TheComet/WalkMod/Hardware/Images/analog_stick.png

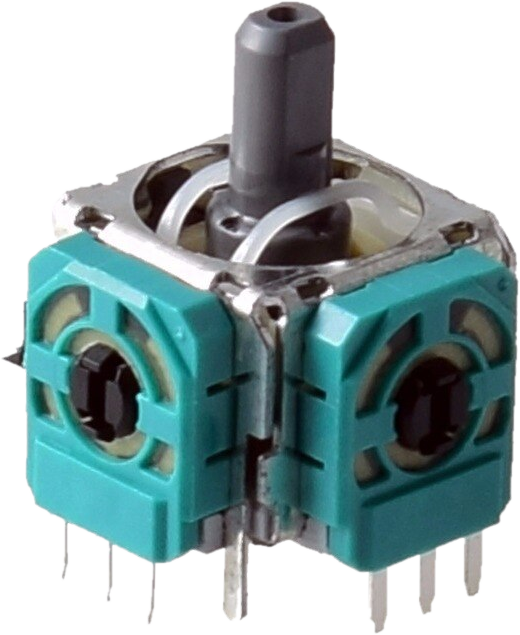
Hardware/Images/analog_stick.png
