TheComet/WalkMod/Hardware/Images/ground.png

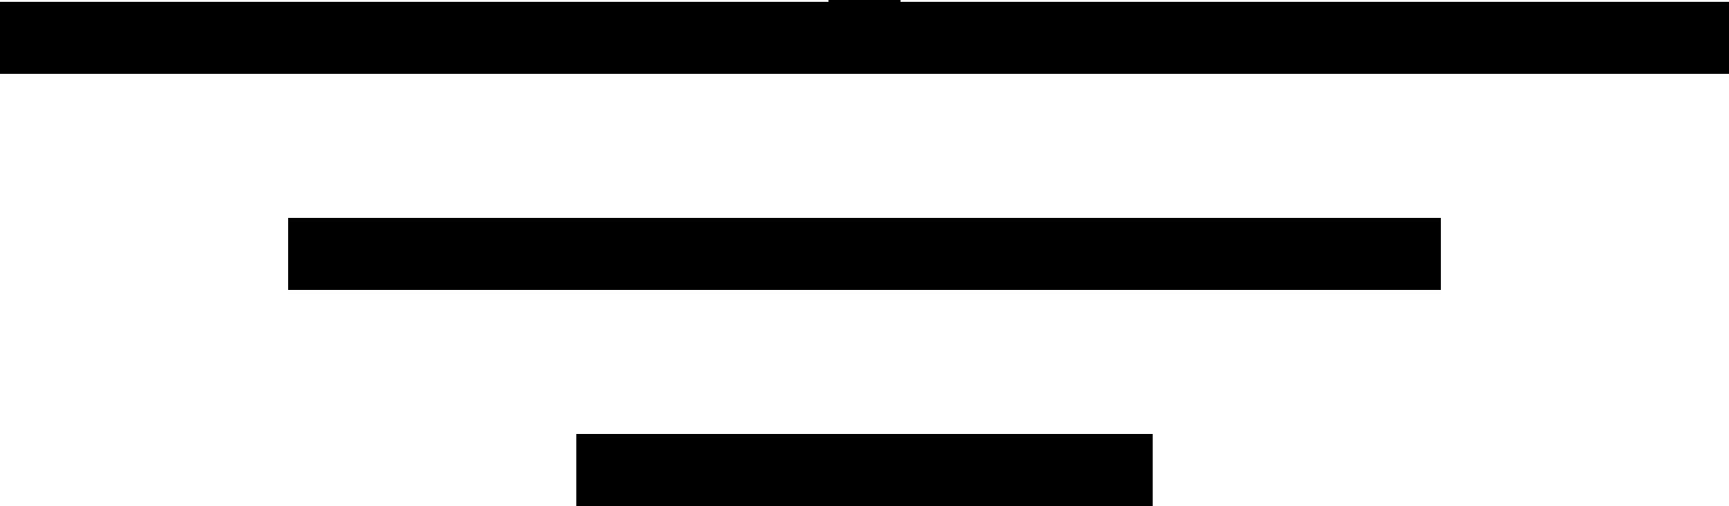
Hardware/Images/ground.png
