TheComet/WalkMod/Hardware/Fabrication/AngleMod V1/BOM/Bill of Materials-AngleMod V1.xlsx

Quantity | Designator | Name | Type | Value | Value2 | Footprint | Manufacturer 1 | Manufacturer Part Number 1 | Supplier 1 | Supplier Part Number 1 | Note
2 | C1, C2 | CC0603KRX7R6BB224 | CC0603KRX7R6BB224 | 220nF | 10V | CX7R0603K
1 | C3 | 06036C105JAT2A |  | 1uF | 6.3V | CX7R0603K
3 | C4, C5, C6 | 04025C104JAT2A |  | 100nF | 50V | CX7R0402C
1 | C7 | 04025C104JAT2A |  | 10nF | 50V | CX7R0402C
7 | P1, P2, P3, P4, P5, P6, P7 | SMD Pad 1 pin |  |  |  | PAD_2X1.5_SQUARE
2 | P8, P9 | TSW-106-23-F-S | TSW-106-23-F-S |  |  | TSW-106-23-F-S_SIDEA | Samtec Inc. | TSW-106-23-F-S
2 | R1, R2 | RG1005P-472-B-T5 | RG1005P-472-B-T5 | 4.7k | 62.5mW | RT0402_C
2 | R3, R4 | TBD | TBD | 10k | 62.5mW | RT0402_C
1 | R5 | TBD | TBD | 470E | 62.5mW | RT0402_C
1 | U1 | TSV632IQ2T | TSV632IQ2T |  |  | DFN-8_2X2_0.5_C | STMicroelectronics | TSV632IQ2T
1 | U2 | NX3L4053HR,115 | NX3L4053HR,115 |  |  | HXQFN-16_SOT-1039-2_C | NX3L4053HR,115 | NXP USA Inc.
1 | U3 | MCP48FVB12-E/UN | MCP48FVB12-E/UN |  |  | MSOP-10_0.5_C | Microchip Technology | MCP48FVB12-E/UN
1 | U4 | PIC16F15245T-I/REB | PIC16F15245T-I/REB |  |  | VQFN-20_0.4_C | Microchip Technology | PIC16F15245T-I/REB
