TheComet/WalkMod/Hardware/Fabrication/Rev C0/BOM/Bill of Materials-WalkMod C0.xlsx

Quantity | Designator | Name | Type | Value | Value2 | Footprint | Manufacturer 1 | Manufacturer Part Number 1 | Supplier 1 | Supplier Part Number 1 | Note
2 | C1, C4 | CL10B105KA8NFNC | CL10B105KA8NFNC | 1uF | 25V | CX7R0603K
1 | C2 | CL10B474KO8NFNC | CL10B474KO8NFNC | 470nF | 16V | CX7R0603K
1 | C3 | CC0603KRX7R6BB224 | CC0603KRX7R6BB224 | 220nF | 10V | CX7R0603K
7 | P1, P2, P3, P4, P5, P6, P8 | SMD Pad 1 pin |  |  |  | PAD_2X1.5_SQUARE
1 | P7 | DS05-127-2-06BK-SMT-TR | DS05-127-2-06BK-SMT-TR |  |  | CUI-DS05-127-2-06BK-SMT_C
1 | Q1 | BC857B-TP | BC857B-TP |  |  | BC8xx_SOT23-3_C
13 | R1, R2, R3, R4, R5, R6, R7, R8, R9, R10, R11, R12, R13 | RG1005P-472-B-T5 | RG1005P-472-B-T5 | 4.7k | 62.5mW | RT0402_C
3 | RA, RB, RC | 3214W-1-103E | 3214W-1-103E | 10k | 250mW | BOURNS_3214W_C | Bourns | 3214W-1-103E | Digi-Key | 3214W-103ETR-ND
1 | U1 | NX3L4053HR,115 | NX3L4053HR,115 |  |  | HXQFN16_SOT1039-2_C | NX3L4053HR,115 | NXP USA Inc.
1 | U2 | LTC2068HUD#PBF | LTC2068HUD#PBF |  |  | QFN16_0.5_C | Analog Devices Inc. | LTC2068HUD#PBF
