TheComet/WalkMod/Hardware/Fabrication/Rev A0/Broad/BOM/Bill of Materials-WalkMod(Broad).xlsx

Quantity | Designator | Name | Type | Value | Value2 | Footprint | Manufacturer 1 | Manufacturer Part Number 1 | Supplier 1 | Supplier Part Number 1 | Note
0 | P1, P2, P3, P4, P5, P6, P7 | SMD Pad 1 pin |  |  |  | PAD_2X1.5_SQUARE, PAD_1.8X0.95_SQUARE
2 | Q1, Q2 | BC857B-TP | BC857B-TP |  |  | BC8xx_SOT23-3_C | MCC | BC857B-TP | Digi-Key | BC857B-TPMSTR-ND
1 | Q3 | BC847B-TP | BC847B-TP |  |  | BC8xx_SOT23-3_C | MCC | BC847B-TP | Digi-Key | BC847B-TPTR-ND
3 | R1, R2, R8 | RT0402DRD0747KL | RT0402DRD0747KL | 47k | 62.5mW | RT0402_C | Yageo | RT0402DRD0747KL | Digi-Key | 311-2187-2-ND
2 | R3, R6 | AT0402FRE0710KL | AT0402FRE0710KL | 10k | 62.5mW | AT0402_C | Yageo | AT0402FRE0710KL | Digi-Key | YAG2104CT-ND
1 | R4 | 3214W-1-103E | 3214W-1-103E | 10k | 250mW | BOURNS_3214W_C | Bourns | 3214W-1-103E | Digi-Key | 3214W-103ETR-ND
1 | R5 | #NAME? | RC0402FR-070RL | 0E | 62.5mW | RC0402_C | Yageo | RC0402FR-070RL | Digi-Key | 311-0.0LRTR-ND
0 | R7 | AT0402FRE0710KL | AT0402FRE0710KL | 10k | 62.5mW | AT0402_C | Yageo | AT0402FRE0710KL | Digi-Key | YAG2104CT-ND
