TheComet/WalkMod/Hardware/Fabrication/AngleMod V1/Doc/AngleMod.PDF

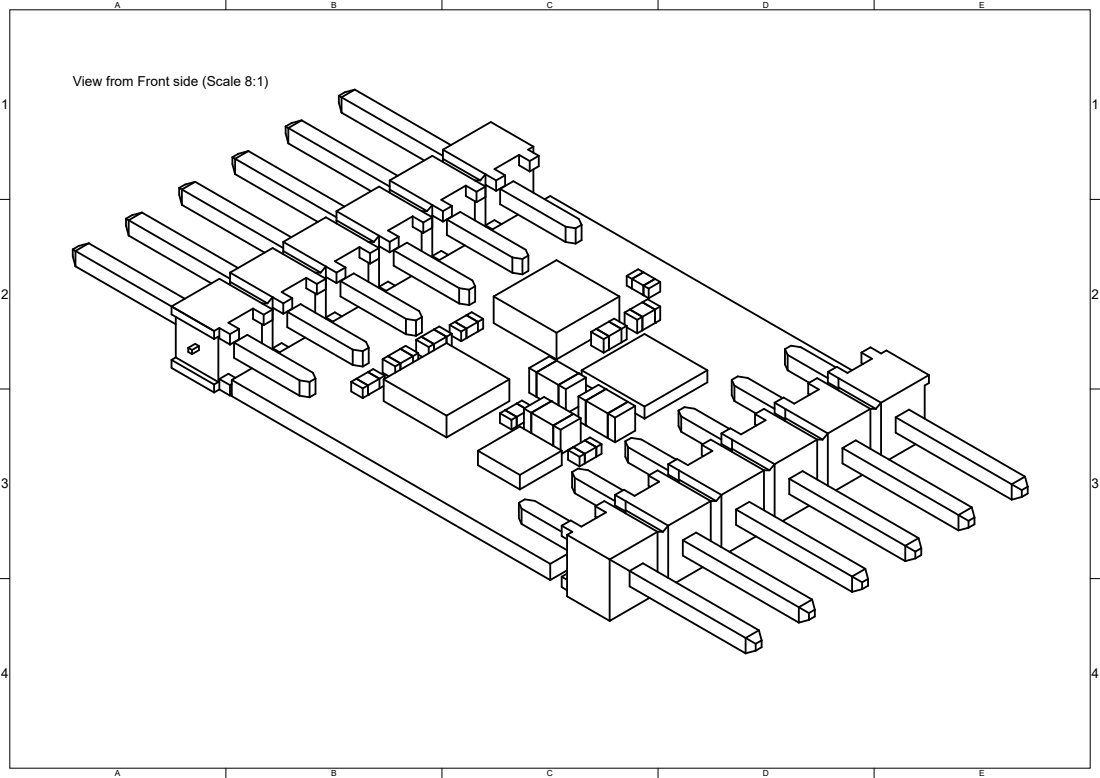
[picture p3: page 1]

View from Front side (Scale 8:1)

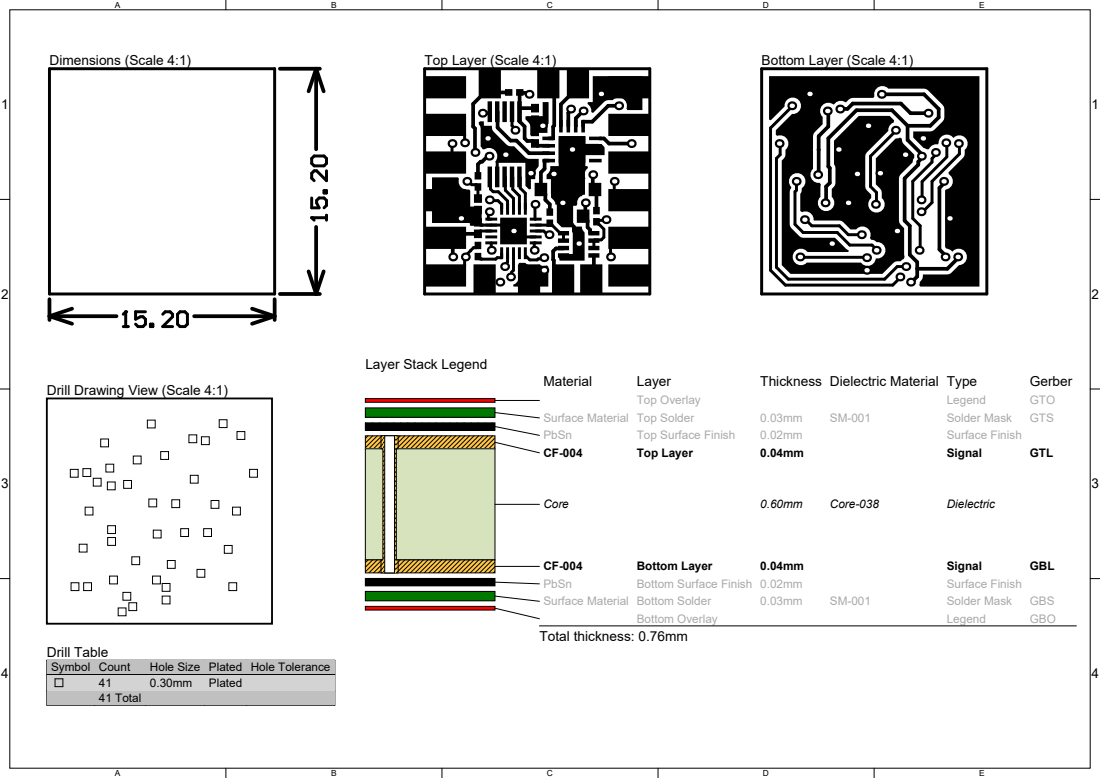
[picture p4: page 2]

Drill Drawing View (Scale 4:1)

Symbol | Count | Hole Size | Plated | Hole Tolerance

41 | 0.30mm | Plated
41 Total

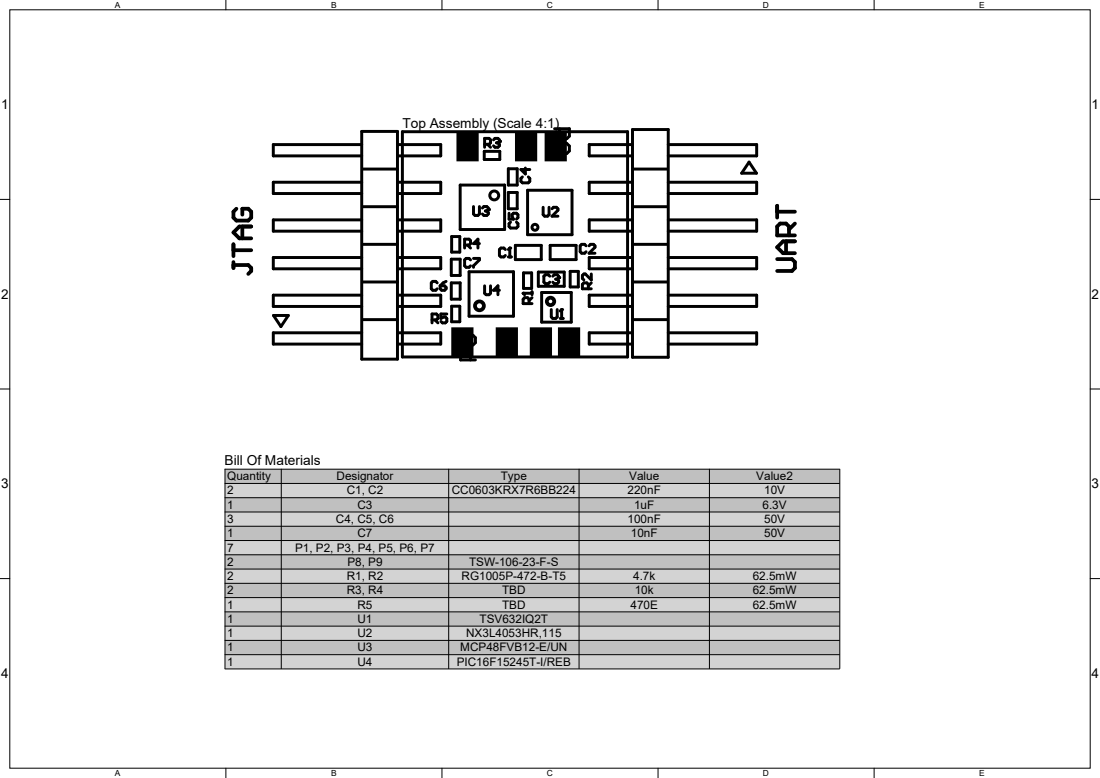
[picture p5: page 3]

Quantity | Designator | Type | Value | Value2
2 | C1, C2 | CC0603KRX7R6BB224 | 220nF | 10V
1 | C3 | | 1uF | 6.3V
3 | C4, C5, C6 | | 100nF | 50V
1 | C7 | | 10nF | 50V
7 | P1, P2, P3, P4, P5, P6, P7
2 | P8, P9 | TSW-106-23-F-S
2 | R1, R2 | RG1005P-472-B-T5 | 4.7k | 62.5mW
2 | R3, R4 | TBD | 10k | 62.5mW
1 | R5 | TBD | 470E | 62.5mW
1 | U1 | TSV632IQ2T
1 | U2 | NX3L4053HR,115
1 | U3 | MCP48FVB12-E/UN
1 | U4 | PIC16F15245T-I/REB

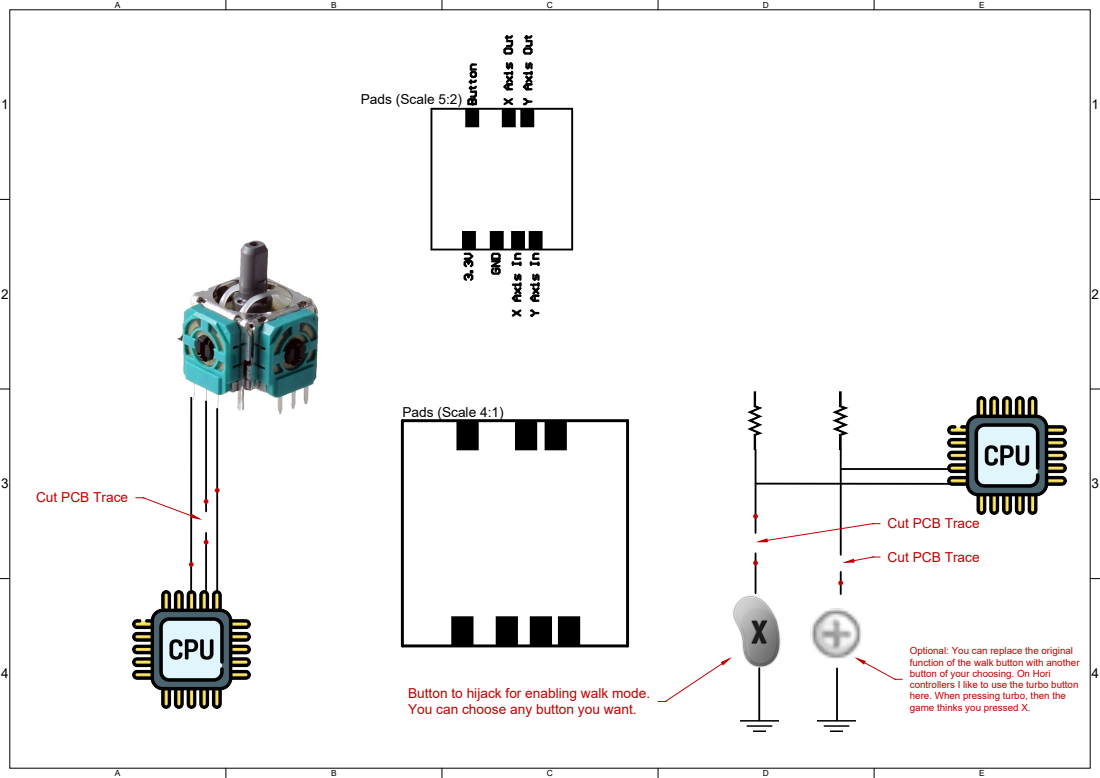
[picture p6: page 4]

Optional: You can replace the original
function of the walk button with another
button of your choosing. On Hori
controllers I like to use the turbo button
here. When pressing turbo, then the
game thinks you pressed X.

Button to hijack for enabling walk mode.
You can choose any button you want.

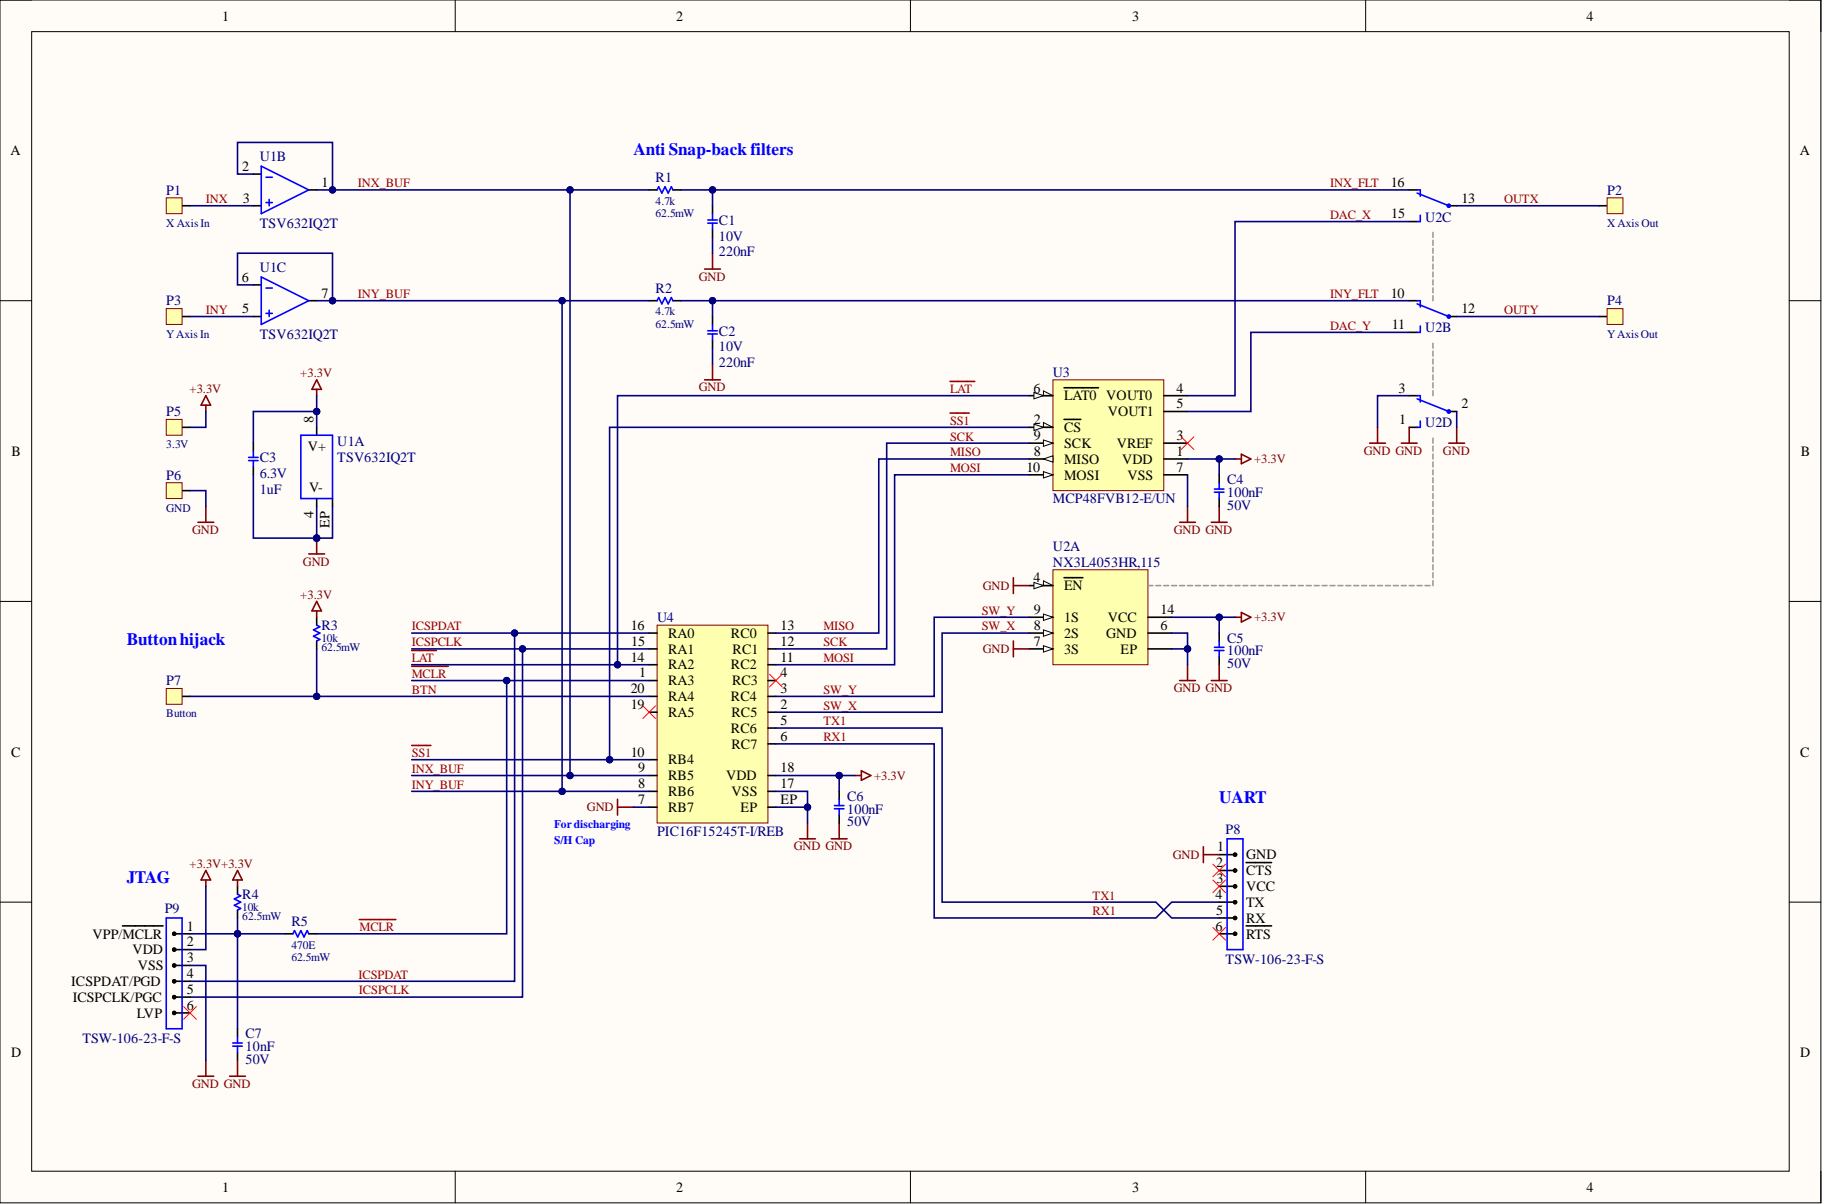
[picture p7: page 5]

8 | SCK 9

n +3.3V | S S 1 IN X_BU F IN Y_BU F MCL R | | S W_X
