TheComet/WalkMod/Hardware/Fabrication/Rev C0/Doc/WalkMod.PDF

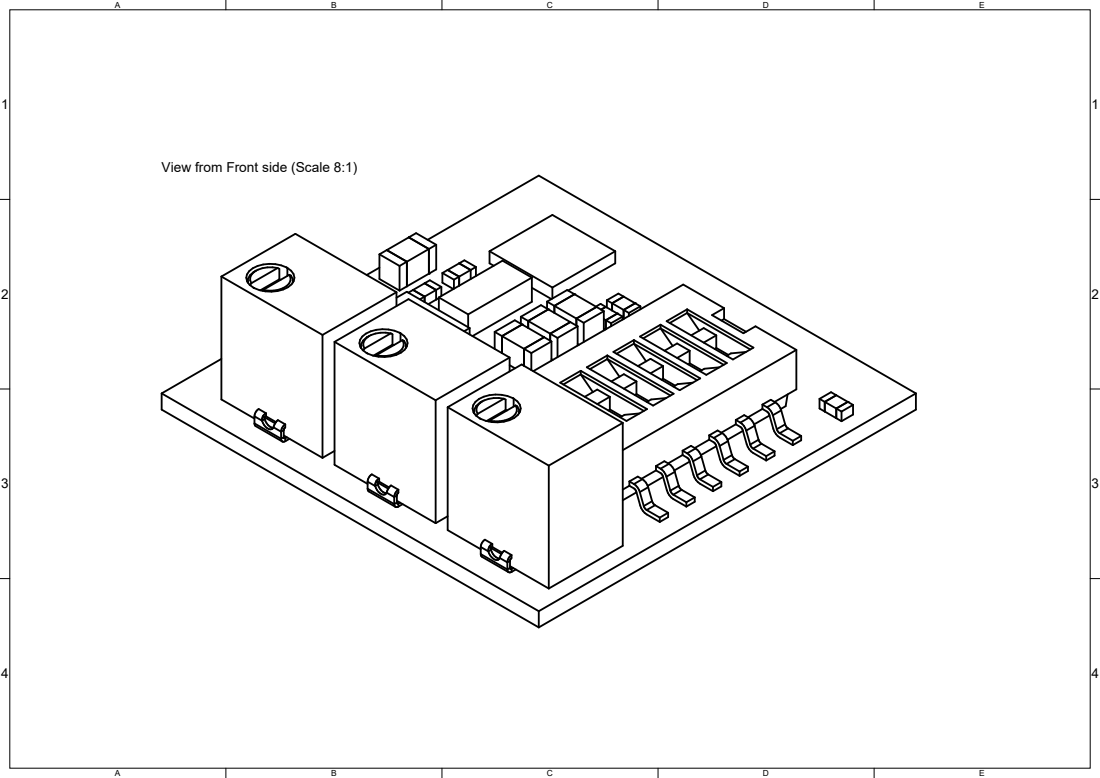
[picture p8: page 1]

View from Front side (Scale 8:1)

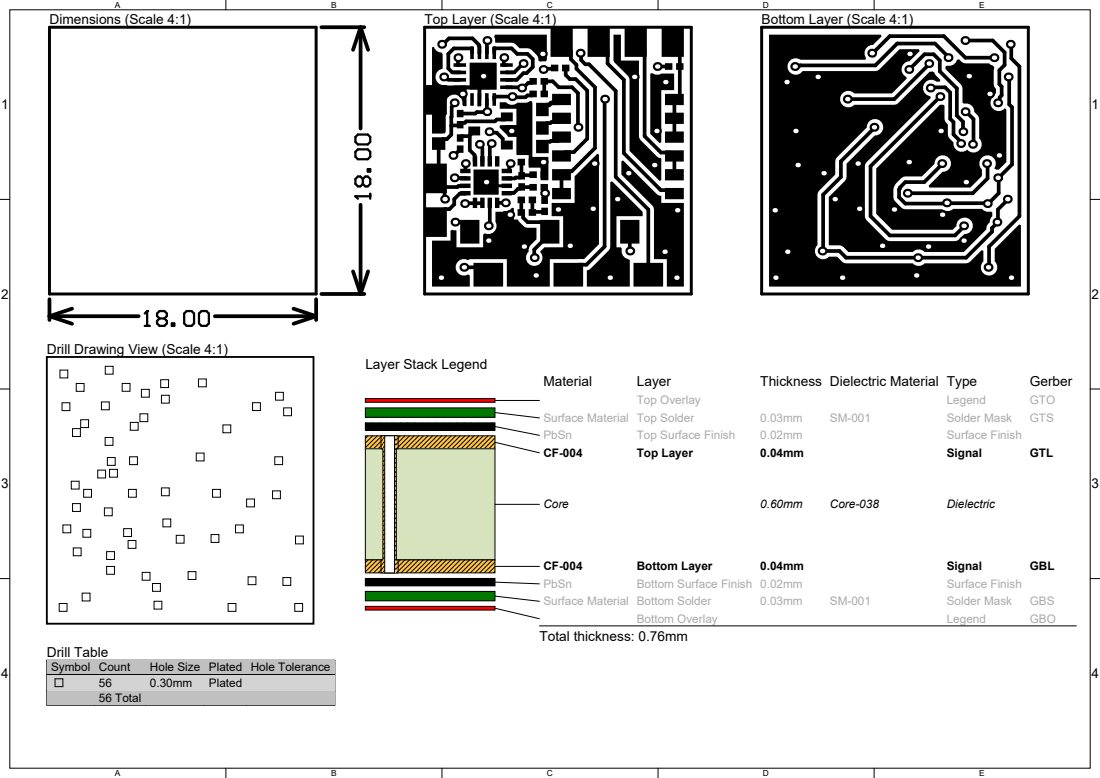
[picture p9: page 2]

Drill Drawing View (Scale 4:1)

Symbol | Count | Hole Size | Plated | Hole Tolerance

56 | 0.30mm | Plated
56 Total

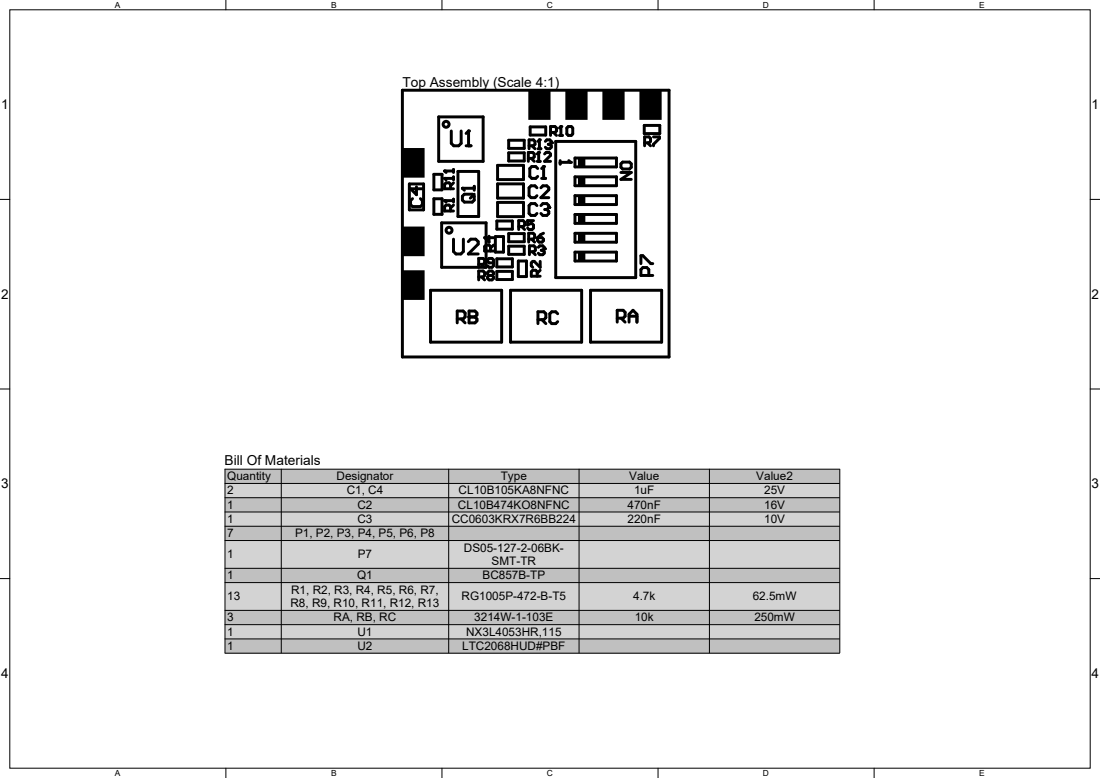
[picture p10: page 3]

Quantity | Designator | Type | Value | Value2
2 | C1, C4 | CL10B105KA8NFNC | 1uF | 25V
1 | C2 | CL10B474KO8NFNC | 470nF | 16V
1 | C3 | CC0603KRX7R6BB224 | 220nF | 10V
7 | P1, P2, P3, P4, P5, P6, P8
1 | P7 | DS05-127-2-06BK-SMT-TR

1 | Q1 | BC857B-TP
13 | R1, R2, R3, R4, R5, R6, R7, R8, R9, R10, R11, R12, R13 | RG1005P-472-B-T5 | 4.7k | 62.5mW

3 | RA, RB, RC | 3214W-1-103E | 10k | 250mW
1 | U1 | NX3L4053HR,115
1 | U2 | LTC2068HUD#PBF

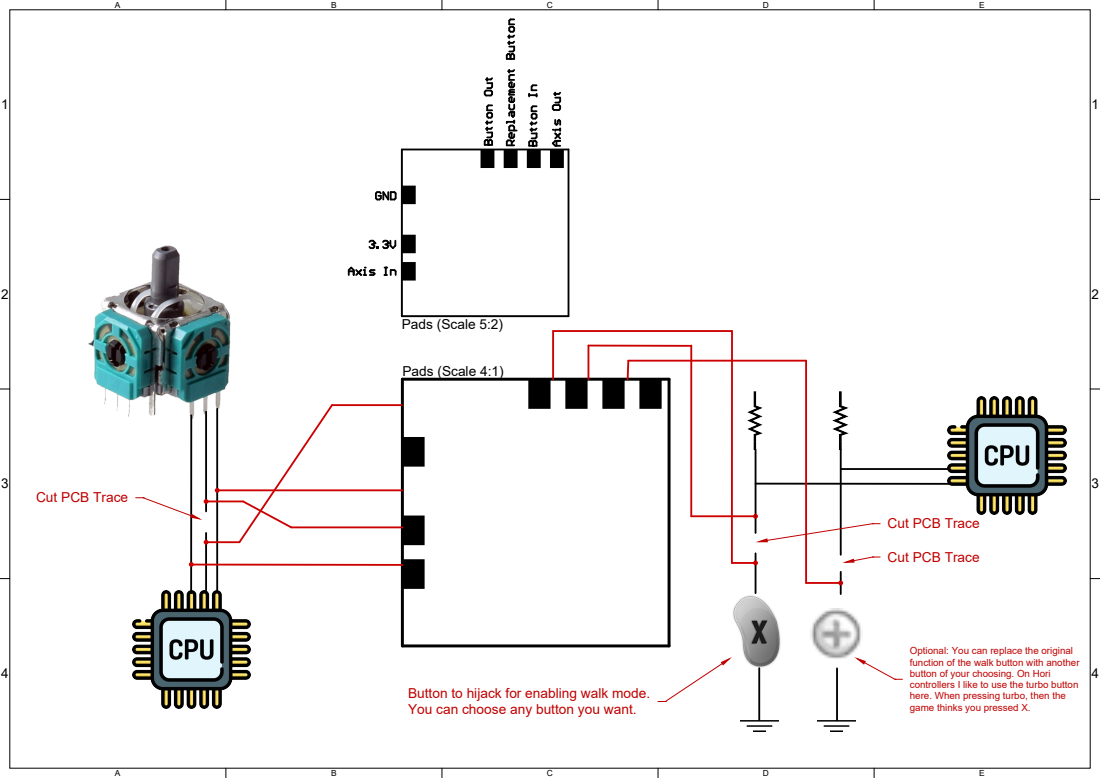
[picture p11: page 4]

Optional: You can replace the original
function of the walk button with another
button of your choosing. On Hori
controllers I like to use the turbo button
here. When pressing turbo, then the
game thinks you pressed X.

Button to hijack for enabling walk mode.
You can choose any button you want.

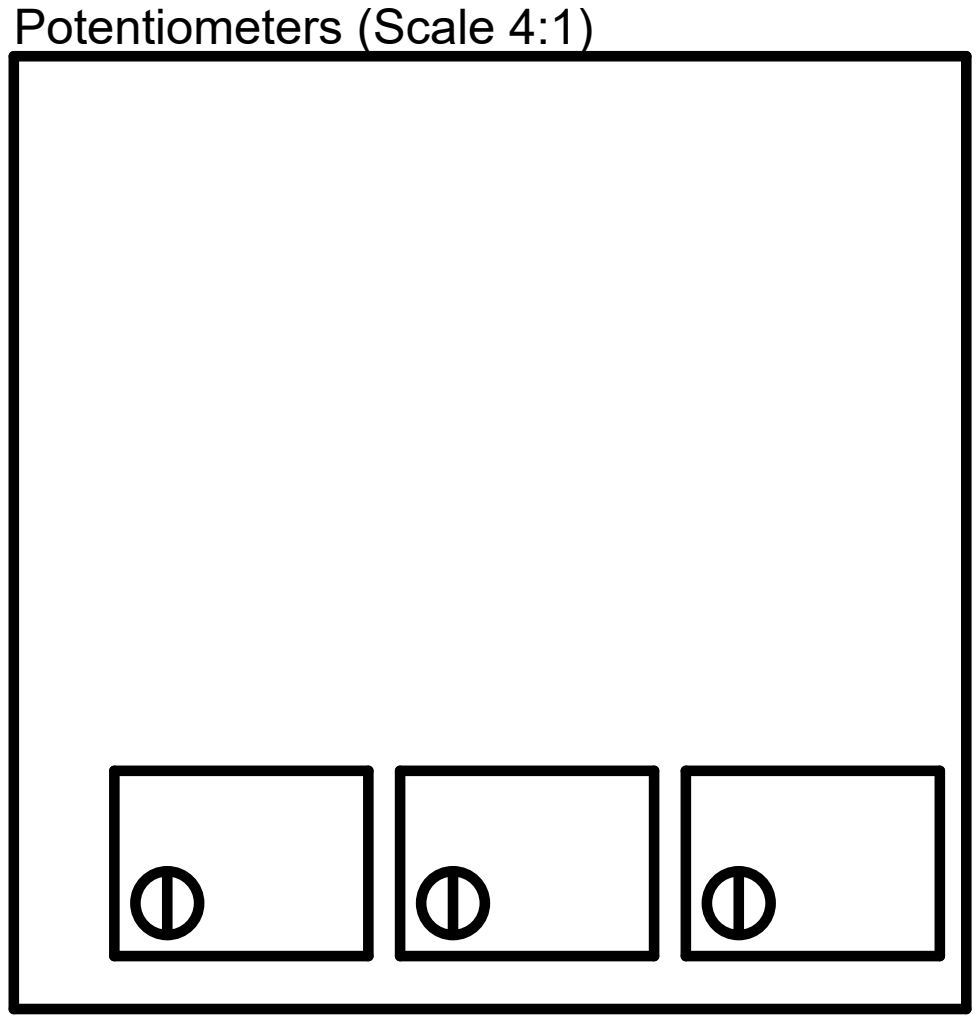
[picture p12: page 5]

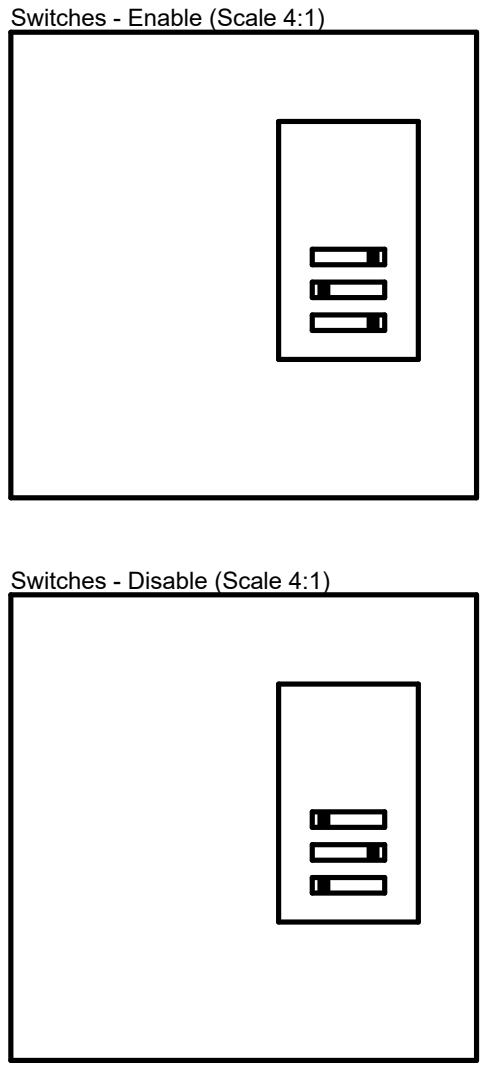
[picture p13: page 6]

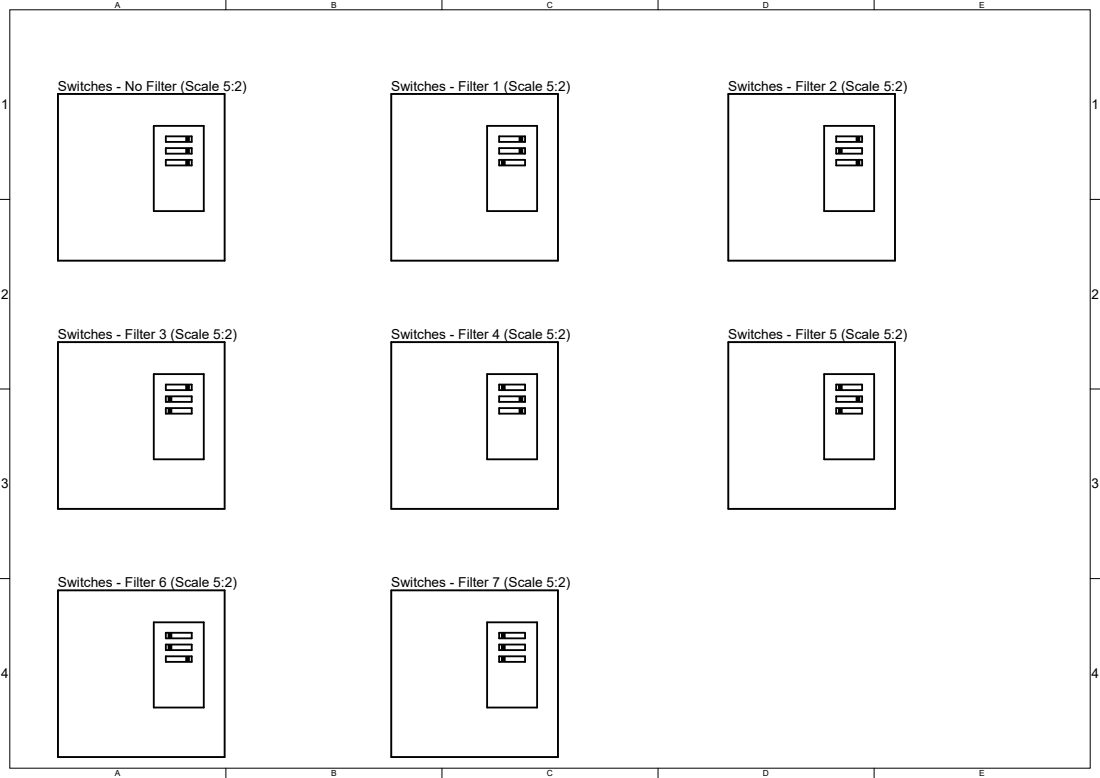
[picture p14: page 7]

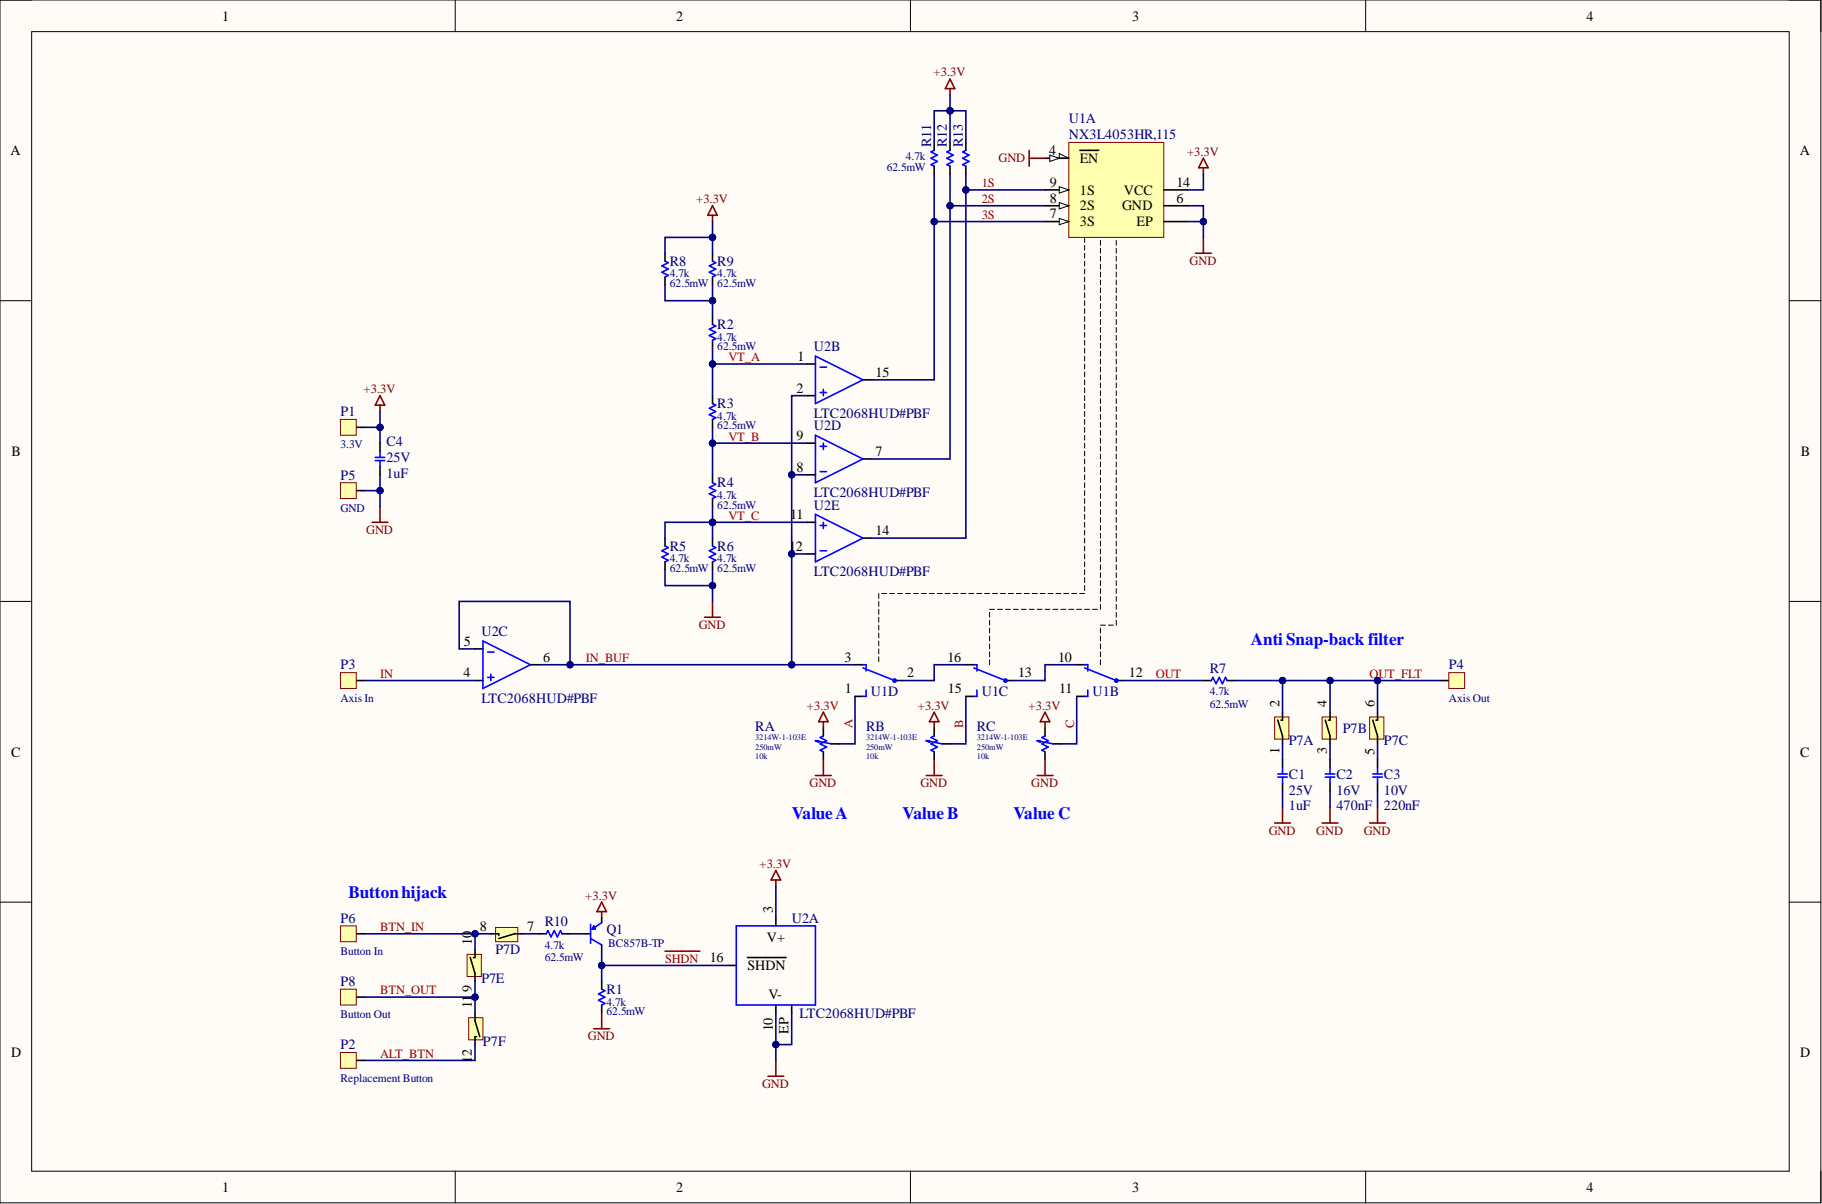
[picture p15: page 8]

Anti Snap-back filter
