TheComet/WalkMod/Hardware/Fabrication/Rev A0/Broad/Doc/WalkMod.PDF

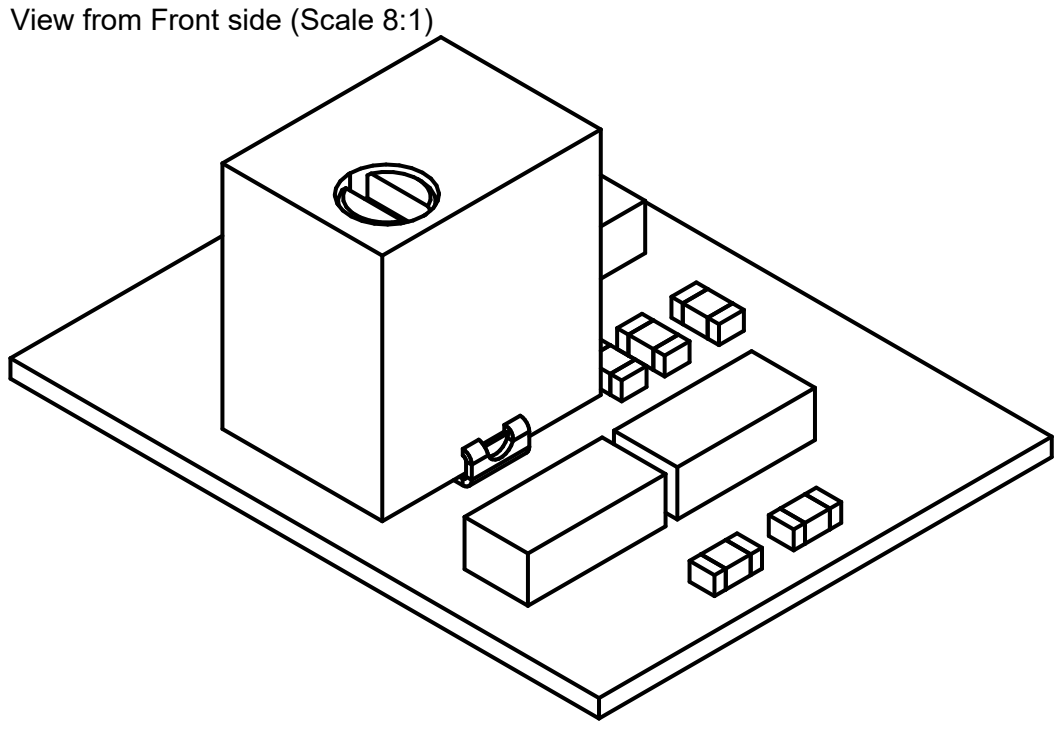
[picture p24: page 1]

View from Front side (Scale 8:1)

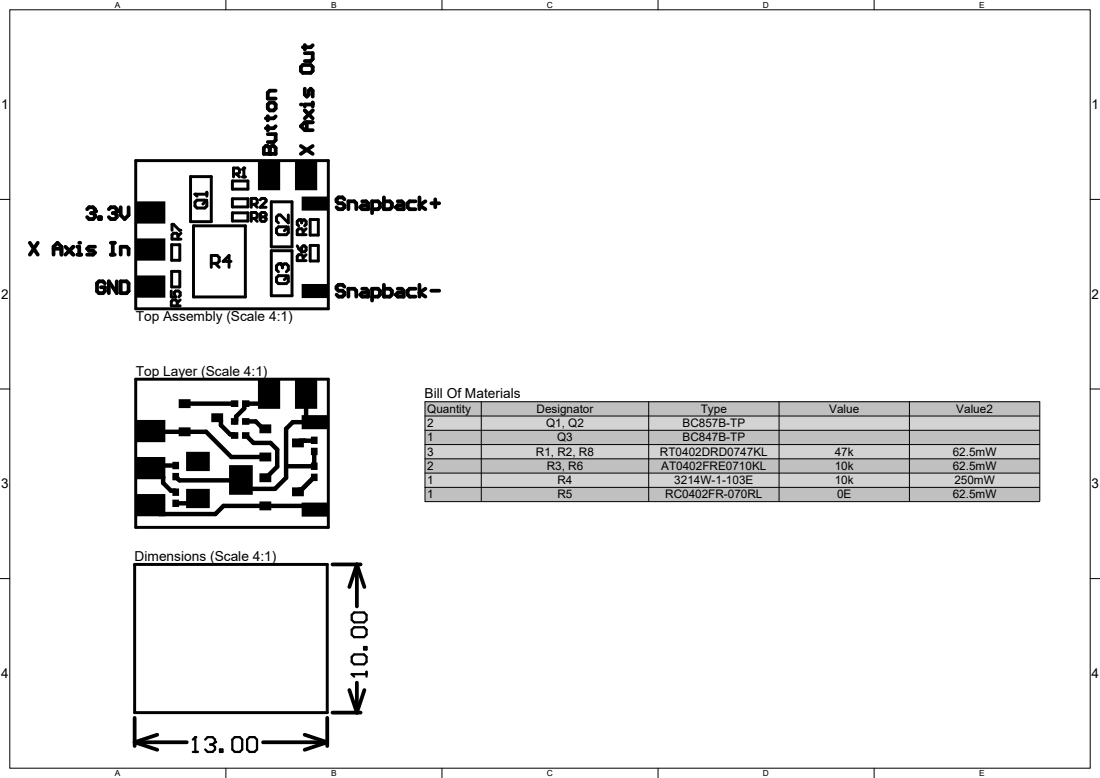
[picture p25: page 2]

Quantity | Designator | Type | Value | Value2
2 | Q1, Q2 | BC857B-TP
1 | Q3 | BC847B-TP
3 | R1, R2, R8 | RT0402DRD0747KL | 47k | 62.5mW
2 | R3, R6 | AT0402FRE0710KL | 10k | 62.5mW
1 | R4 | 3214W-1-103E | 10k | 250mW
1 | R5 | RC0402FR-070RL | 0E | 62.5mW

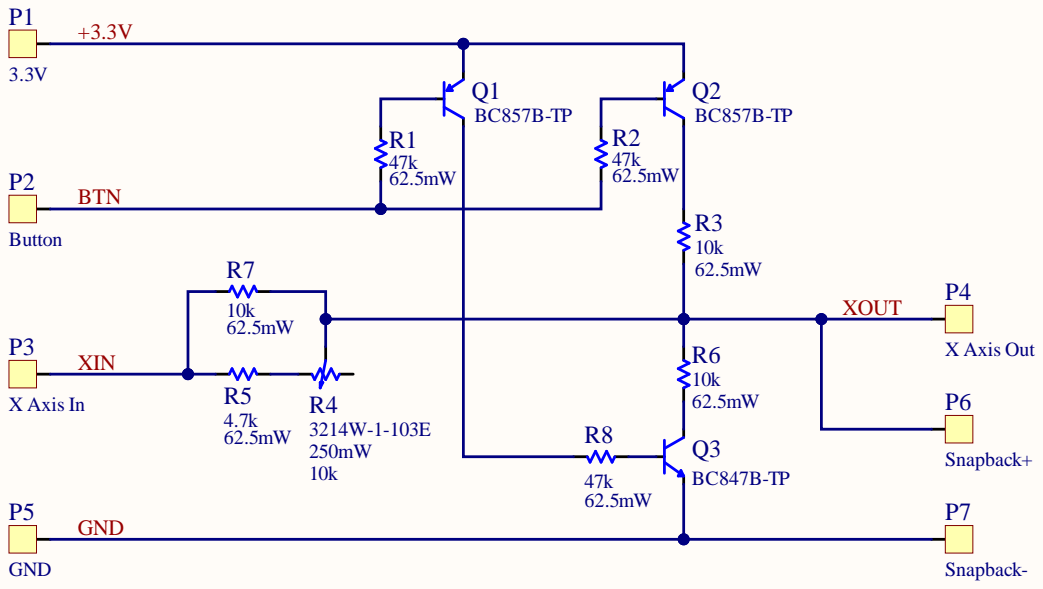
[picture p26: page 3]
