TheComet/WalkMod/Simulations/WalkMod2.asc

A1: xor
A2: xor
R1: res; {Rx-xpos*Rx}
R2: res; {xpos*Rx}
R3: res; 2.2k
R4: res; 10k
R5: res; 2.2k
R6: res; 10k
R7: res; 4.7k
R8: res; 10k
R12: res; {Rx-xpos*Rx}
R13: res; {xpos*Rx}
R14: res; 1483
R15: res; 517
S1: sw
U4: LT1810
V1: voltage; 3.3
V2: voltage; 2.15
V3: voltage; 1.15
V4: voltage; 2.4469
Named nets: 0, +3.3V, normal, target, tilt_l, tilt_h, dzip
.param Rx=10k
.step param xpos 0.01 0.99 0.01
.op
.param Rtrim=10k
