TheComet/WalkMod/Simulations/WalkMod.asc

Q1: pnp; BC807-16
Q2: npn; BC817-16
Q3: pnp; BC807-16
R1: res; {Rx-xpos*Rx}
R2: res; {xpos*Rx}
R3: res; 4.7k
R4: res; {Rtrim*trimpos}
R5: res; 10k
R6: res; 47k
R7: res; 47k
R8: res; 47k
R9: res; 10k
R10: res; 10k
R11: res; 2k
R12: res; {Rx-xpos*Rx}
R13: res; {xpos*Rx}
R14: res; 1483
R15: res; 517
V1: voltage; 3.3
Named nets: 0, +3.3V, modded, normal, target
.param Rx=10k
.step param xpos 0.01 0.99 0.01
.op
.param Rtrim=10k
.step param trimpos 0.1 0.9 0.1
