TheComet/WalkMod/(list of files, drawings)

Other design files:
Hardware/AngleMod V1/AngleMod V1.PcbDoc
Hardware/AngleMod V1/AngleMod V1.PrjPcb
Hardware/AngleMod V1/AngleMod V1.SchDoc
Hardware/WalkMod A0/WalkMod A0.PcbDoc
Hardware/WalkMod A0/WalkMod A0.PrjPcb
Hardware/WalkMod A0/WalkMod A0.SchDoc
Hardware/WalkMod B0/WalkMod B0.PcbDoc
Hardware/WalkMod B0/WalkMod B0.PrjPcb
Hardware/WalkMod B0/WalkMod B0.SchDoc
Hardware/WalkMod C0/WalkMod C0.PrjPcb
Hardware/WalkMod C0/WalkMod C0.SchDoc
Hardware/WalkMod/WalkMod.PrjPcb
