TheComet/WalkMod/Firmware/AngleMod/AngleMod.X/src/param.c

#include "anglemod/param.h"
#include "anglemod/cmd_seq.h"
#include <xc.h>

#if !defined(CLI_SIM) && !defined(GTEST_TESTING)
#pragma config SAFEN = 0
#endif

static struct param param;

/* -------------------------------------------------------------------------- */
void param_load_from_nvm(void)
{
    uint8_t* data_start = (uint8_t*)&param;
    uint8_t* data_end = (uint8_t*)&param + sizeof(param);
    
    /* Address of last row? (0x3FE0 - 0x3FFF is 32 14-bit words right? */
    /* This is where we will save the structure */
    uint16_t saf_addr = 0x3FE0;
    
    while (data_start != data_end)
    {
        NVMCON1bits.NVMREGS = 0;  /* Point to PFM (instead of config) */
        NVMADR = saf_addr;        /* Address of word to read */
        NVMCON1bits.RD = 1;       /* Initiate read cycle */
        *data_start = NVMDATL;
        
        data_start++;
        saf_addr++;
    }
    
    /* See if the data we read makes any sense. If not, load the struct with
     * default values */
    if (param.dac_clamp.xl == param.dac_clamp.xh)
    {
        param_set_defaults();
    }
}

/* -------------------------------------------------------------------------- */
void param_set_defaults(void)
{
    param.enable.normal_mode = 0x01;  /* Clamp mode */
    param.enable.cardinal_angles = 0xFF;
    param.enable.diagonal_angles = 0xFF;
    param.enable.special_angles = 0x1F;

    param.cmd_seq.xythreshold = 42;
    param.cmd_seq.hysteresis = 30;

    param.dac_clamp.xl = 85;
    param.dac_clamp.xh = 171;
    param.dac_clamp.yl = 85;
    param.dac_clamp.yh = 171;

#define X(name, str, mirrx, mirry, init_x, init_y) \
    param.angles[SEQ_##name - 1].x = init_x; \
    param.angles[SEQ_##name - 1].y = init_y;
    SEQ_LIST
#undef X
}

/* -------------------------------------------------------------------------- */
struct param* param_get(void)
{
    return &param;
}

/* -------------------------------------------------------------------------- */
void param_save_to_nvm(void)
{
    const uint8_t* data_start = (uint8_t*)&param;
    const uint8_t* data_end = (uint8_t*)&param + sizeof(param);
    
    /* 1 row consists of 32 14-bit program memory words. */
    /* SAF spans 128 words from 0x3F80 - 0x3FFF */
    
    /* Address of last row? (0x3FE0 - 0x3FFF is 32 14-bit words right? */
    /* This is where we will save the structure */
    uint16_t saf_addr = 0x3FE0;
    
    INTCONbits.GIE = 0;
    
    NVMCON1bits.NVMREGS = 0;  /* Point to PFM (instead of config) */
    NVMADR = saf_addr;        /* Specify beginning of PFM row to erase */
    NVMCON1bits.FREE = 1;     /* Specify an erase operation */
    NVMCON1bits.WREN = 1;     /* Allow erase cycle */
    
    /* Unlock sequence */
    NVMCON2 = 0x55;
    NVMCON2 = 0xAA;
    NVMCON1bits.WR = 1;
    
    NVMCON1bits.LWLO = 1;     /* Load write latches */
    while (data_start != data_end)
    {
        NVMADR = saf_addr;
        NVMDATL = *data_start;
        NVMCON2 = 0x55;
        NVMCON2 = 0xAA;
        NVMCON1bits.WR = 1;
        
        saf_addr++;
        data_start++;
    }
    
    /* Since our struct fits into just one row, can write it outside of the loop */
    NVMCON1bits.LWLO = 0;  /* Start PFM write */
    
    NVMCON1bits.WREN = 0;  /* Disable writes */
    INTCONbits.GIE = 1;    /* Enable interrupts */
}
