TheComet/WalkMod/(commit log)

2022-02-14 Narrow/Broad variations
    [WalkMod.PcbDoc, WalkMod.PrjPcb, WalkMod.SchDoc]
2022-02-14 Production data
    [Bill of Materials-WalkMod(Broad).xlsx, Bill of Materials-WalkMod(Narrow).xlsx, Pick Place for WalkMod(Broad).csv, Pick Place for WalkMod(Narrow).csv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]
2022-05-03 Finished V2
    [WalkMod A0.PcbDoc, WalkMod A0.PrjPcb, WalkMod A0.SchDoc, WalkMod B0.PcbDoc, WalkMod B0.PrjPcb, WalkMod B0.SchDoc]
2022-05-03 Finished B0
    [Bill of Materials-WalkMod B0.xlsx, Pick Place for WalkMod B0.csv, WalkMod A0.PcbDoc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]
2022-05-11 Rev B0
    [Bill of Materials-WalkMod B0.xlsx, Pick Place for WalkMod B0.csv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]
2022-05-15 Finished C0
    [Bill of Materials-WalkMod C0.xlsx, Pick Place for WalkMod C0.csv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]
2022-05-16 Using new OpAmp, re-did layout
    [Bill of Materials-WalkMod C0.xlsx, Pick Place for WalkMod C0.csv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]
2022-05-16 Adding AngleMod project
    [AngleMod V1.PcbDoc, AngleMod V1.PrjPcb, AngleMod V1.SchDoc, WalkMod A0.PrjPcb, WalkMod B0.PrjPcb, WalkMod C0.PrjPcb]
2022-05-16 first draft of schematic done
    [AngleMod V1.PcbDoc, AngleMod V1.PrjPcb, AngleMod V1.SchDoc]
2022-05-17 Layout pretty much done
    [AngleMod V1.PcbDoc, AngleMod V1.PrjPcb, AngleMod V1.SchDoc]
2022-05-18 AngleMod V1 done
    [AngleMod V1.GBL, AngleMod V1.GBP, AngleMod V1.GBS, AngleMod V1.GKO, AngleMod V1.GM1, AngleMod V1.GTL, AngleMod V1.GTO, AngleMod V1.GTP]
2022-05-21 Working on firmware
    [AngleMod V1.PcbDoc]
2022-05-22 uart ring buffer
2022-05-30 Implementing DAC and SPI stuff
2022-05-30 Removing uart_putbytes() in favor of uart_putc()
2022-06-07 Fixing unicode in cli-sim
    [cli.c, main.cpp]
2022-06-07 (Hopefully) writing config struct to NVM correctly now
    [config.c, pic16f152.cpp, xc.h]
2022-06-12 Fixing bugs and got everything working except for DAC
    [adc.c, btn.c, cli.c, config.c, dac.c, gpio.c]
2022-06-12 Fixing DAC stuff (still has some issues)
    [cli.c, dac.c, gpio.c]
2022-06-12 Making GND connection a little nicer to DAC
    [AngleMod V1.PcbDoc]
2022-06-14 Fixed button stuff
